elo3451/A24_ruler/Sponsor/README.md

# **Please Read**
Please contribute to this list so it does not get bad and unmaintained like the adawiki list this is based off.

# **The Basics**

- Don&#39;t ask for more than you need
- Do not resell samples (this is why TI stopped sending samples to students)
- Be prepared for a barrage of phone calls from some manufacturers.

- You may be questioned about the use of samples. Know your project

# **Side note**
Some companies use samplecomponents to process samples. This is a google query that'll find all of them
site:samplecomponents.com/scripts/samplecenter.dll?*?cmd=menu "sample center"
Please report back anything useful
# **The List**

# Recommended
[Maxim Integrated ](http://www.maximintegrated.com/)Sends samples only if you have a corporate/school email. Quick turnaround (3 days) and uses DHL Express WPX.

[Microchip ](https://www.microchip.com/samples/) IC's / Microcontrollers. They make all kinds of stuff. I used my personal email which is on a custom domain. They do not accept common emails such as @gmail.com. I have ordered from there so much and they do not bug you / &quot;follow up&quot;. DHL Express WPX.

[NXP](http://www.nxp.com/) IC's / Microcontrollers. Pretty good. They even offer free &quot;priority&quot; shipping if you click the button that asks. FedEX Express.

[Renesas](http://renesas.com/) IC's / Microcontrollers. Pretty good. They send samples of cheap stuff within a week and also fulfilled my requests for more expensive parts. FedEX Express.

[Micron](http://micron.com/) IC's / Microcontrollers. Sends samples free via USPS Priority Mail. Takes 1+ months.

[TE](http://te.com/) Passives, Connectors, Switches. TE Connectivity. Pretty good. Sent multiple orders with more expensive parts. All were shipped very quickly. I got 1 email from sales, but they haven&#39;t bugged me. FedEX Express.

[Amphenol ICC](http://amphenol-icc.com/) Connectors. Sent my connectors using UPS Saver. Pretty quick turnaround.

[Nexperia](http://www.nexperia.com/) ICs. Writing the sales office a short email about your project is the way to go. Very quick response and delivery.

# IC&#39;s / Microcontrollers

[Maxim Integrated ](http://www.maximintegrated.com/)Sends samples only if you have a corporate/school email. Quick turnaround (3 days) and uses DHL Express WPX.

[Analog Devices](http://www.analog.com/en/index.html) Samples only if you have a corporate/university E-Mail ID. Usually require an EORI number for EU shipping (you can fill in the field with N/A and mention you are a student) but this might get you in trouble with customs. You are required to fill in details about what project the samples will be used in. Only one samples account per person is allowed. Limit samples orders to two parts of each type, and five types in total.

[Texas Instruments (National Semi)](https://www-a.ti.com/apps/samp/basket.asp) TI says that samples requests are only for professional engineers and fobs you off to the TI Store.

[Microchip ](https://www.microchip.com/samples/)The Best. They make all kinds of stuff. I used my personal email. They do not accept common emails such as @gmail.com. I have ordered from there so much and they do not bug you / &quot;follow up&quot;

[Silicon Laboratories](http://www.silabs.com/) Sent request and was shipped quickly via DHL 

[STMicroelectronics](http://www.st.com/) Ordered and sent DHL non tracked. They want $7 for shipping to Australia. They had a free shipping offer for New Years.

[ON Semiconductor](http://www.onsemi.com/) ON wants $15 for shipping + $5 for handling. Have not tried.

[NXP](http://www.nxp.com/) Pretty good. They even offer free &quot;priority&quot; shipping if you click the button that asks.

[Cirrus Logic ](http://www.cirrus.com/)Haven&#39;t tried yet

[Allegro Microsystems](http://www.allegromicro.com/) No option for samples on website.

[Sensirion](http://www.sensirion.com/) No free samples at the moment.

[Central Semi](http://centralsemi.com/) Website is broken. Uses old recapcha.

[Zilog](http://www.zilog.com/) Not much choice. I requested samples a while ago and no response.

[Austria Microsystems](http://ams.com/) Gotten samples with no &quot;follow up&quot;. DHL Express WPX.

[Macronix International](http://macronix.com/) They do not want to send samples and if you really ask them, they will ask you for a shipping account number.

[Renesas](http://renesas.com/) Pretty good. They send samples of cheap stuff within a week and also fulfilled my requests for more expensive parts. FedEX Express.

[Micron](http://micron.com/) IC's / Microcontrollers. Sends samples free via USPS Priority Mail. Takes 1+ months.

[Micro Crystal](https://www.microcrystal.com/en/) Real Time clock and crystal oscilator. Sends a demo bard and 5 pieces sample. Forwarded my details to annoying distirbutor. FedEX Express.

[Nexperia](http://www.nexperia.com/) ICs. Writing the sales office a short email about your project is the way to go. Very quick response and delivery.

# Passives / Opto / Discrete Semi

[Vishay](http://vishay.com/) They don&#39;t send samples (if) you can find a part that Vishay &quot;stocks&quot;

[TE](http://te.com/) TE Connectivity. Pretty good. Sent multiple orders with more expensive parts. All were shipped very quickly. I got 1 email from sales, but they haven&#39;t bugged me. FedEX Express

[Würth Elektronik](https://www.we-online.com/catalog/en) Pretty good. Sales rep called me next day to check on project and to ask how I found out about them, etc. FedEX Express.

[Bivar](http://www.bivar.com/) They do not send samples and want you to buy them.

[Lite-On](http://us.liteon.com/en-global/Home/index) Sent request.

# Connectors

[TE](http://te.com/) Connectivity. Sent multiple orders with more expensive parts. I got 1 email from sales, but they haven&#39;t bugged me. FedEX Express.

[SamTec](http://www.samtec.com/) No response yet.

[Mill-Max](http://www.mill-max.com/) Sent request.

[Desco / Charleswater](http://desco.descoindustries.com/) Will only send to "professional engineers"

[ITW/Fastex](http://www.itw-fastex.com/catalog.html) Have not tried.

[Keystone electronics](http://www.keyelco.com/contact.asp) They sent my request to a distributor who has not contacted me.

[Metz Connect](https://www.metz-connect.com/us/sample-order) Have not tried.

[Memory Protection Devices](http://www.memoryprotectiondevices.com/morecorp.shtml) No form for samples on website. Have not tried emailing them.

[Norcomp](http://www.norcomp.net/Navpages/sample.htm) Need shipping account. Have not tried.

[Amphenol ICC](http://amphenol-icc.com/) Sent my connectors using UPS Saver. Pretty quick turnaround.

[3M](http://solutions.3m.com/wps/portal/3M/en_WW/electronics/home/SupportTraining/ContactUs/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) Their website is hard to navigate and I cannot find a samples request form for Australia.

# Enclosures

[PacTec Enclosures](http://www.pactecenclosures.com/free_sample.lfml) Have not tried.

[OKW Enclosures](http://www.okwenclosures.com/) - No responce.

[Serpac](http://www.serpac.com/) No responce. 

[Hammond Manufacturing](http://www.hammfg.com/) No sampling option on webpage. Have not tried.

# Switches

[NKK Switches](http://www.nkkswitches.com/) Shipping account required if you want UPS or FedEx. Have not tried.

[TE](http://te.com/) Connectivity. Sent multiple orders with more expensive parts. I got 1 email from sales, but they haven&#39;t bugged me.

# Others

[MicroMetals](http://www.micrometals.com/samples_index.html) No option on website. Have not tried.

[Fox Electronics](http://www.foxonline.com/) No responce.

[Purdy Electronics](http://www.purdyelectronics.com/) No form on website. They will send you off to a distributor to buy it.

[RichCo Inc](http://www.richco-inc.com/sampleframes.asp/) Have not tried.

[Coilcraft](http://www.coilcraft.com/) Inductors, Transformers and other high-quality magnetics. They are very generous with samples. You can contact a sales rep, and they will provide you with samples regardless of if you are working, a student or just an independent hobbyist. Contacting them through a regular E-Mail domain (e.g. @gmail.com) also works.

[Parallax](http://www.parallax.com/) No form on website. They said they do not do samples.

[LittelFuse](http://www.littelfuse.com/) Have not tried.

[Bourns](http://www.bourns.com/SampleReq.aspx) Not even going to try. Apparently they will pester you consistently.

[Ametherm](http://www.ametherm.com/SampleRequest.html) Free shipping only for usa and Canada. Have not tried.

[AVX Corporation](https://www.avx.com/RequestSample.asp) No responce.

[KOA Speer Electronics](http://www.koaspeer.com/order-samples/) Sales rep emailed me saying they do not send samples.

[Central Technologies](http://www.ctparts.com/) Have not tried.

[API Delevan](http://www.delevan.com/support/sample) Have not tried.

[SJS Products](http://www.sjsproducts.com/us/requests/request/quote) Have not tried.

[Ecliptek](http://www.ecliptek.com/) Asked for samples and no response.
