elo3451/A24_ruler/Remise finale/Documentation_conception/Notes de conception.pdf

Digikey - Atmega328P-AU (https://www.digikey.ca/en/products/detail/microchip-technology/ATMEGA328P-AU/1832260)
Symbole disponible sur Kicad
À voir le type d'empreinte disponible (modèle avec des pages vers l'extérieur)

Prix : 4.16$

Références:
Empreinte - SnapMagic (https://www.snapeda.com/parts/ATMEGA328P-AU/Microchip/view-part/)
Informations - Mouser (https://www.mouser.ca/ProductDetail/Microchip-Technology/ATMEGA328P-AU?qs=K8BHR703ZXiCmmgp6%2FGNmQ%3D%3D)
IGM - Arduino : getting started (https://igm.univ-mlv.fr/~dr/XPOSE2013/arduino/started.html) Pins type - DANKC (https://dankc.com/using-atmega328p-8-16-20mhz/)
Fiches technique - ATMEGA328P-AU (https://www.alldatasheet.fr/datasheet-pdf/download/392285/ATMEL/ATMEGA328P-AU.html)
Hardware design considerations | AN2519-AV R-Microc...
Manuel | ATMEGA32 8p (1) (1)
Measure VCC/Battery Voltage Without Using I/O Pin on tinyAVR and megaAVR | 00002447A

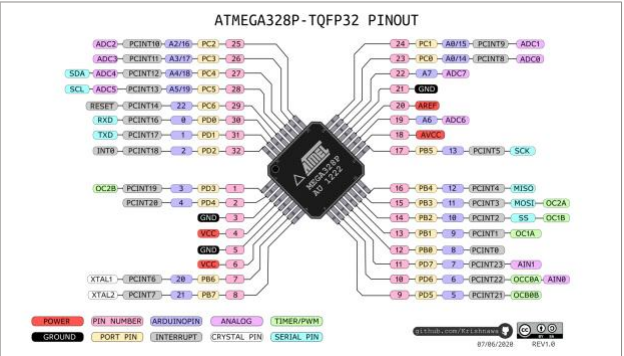
[picture p1: figure]
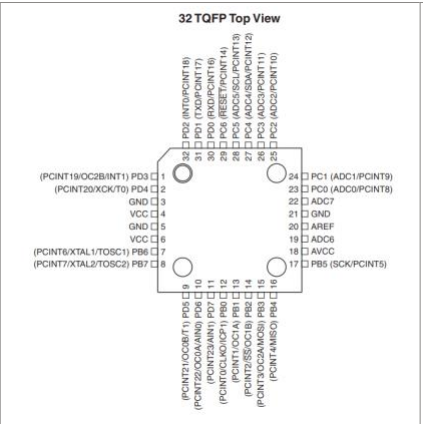
[picture p2: figure]

Pin layout (p.12):

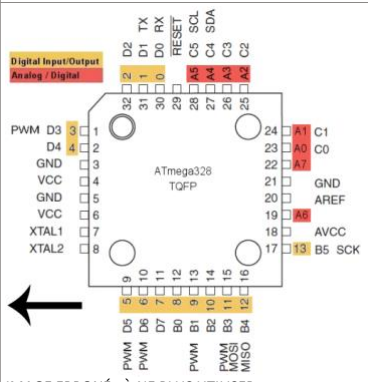
[picture p3: figure]

IMAGE ERRONÉ - À NE PLUS UTILISER

## Atmega328P-AU (TQFP)

mercredi 30 octobre 2024 20:05

A24 - Inch2Cent Page 1

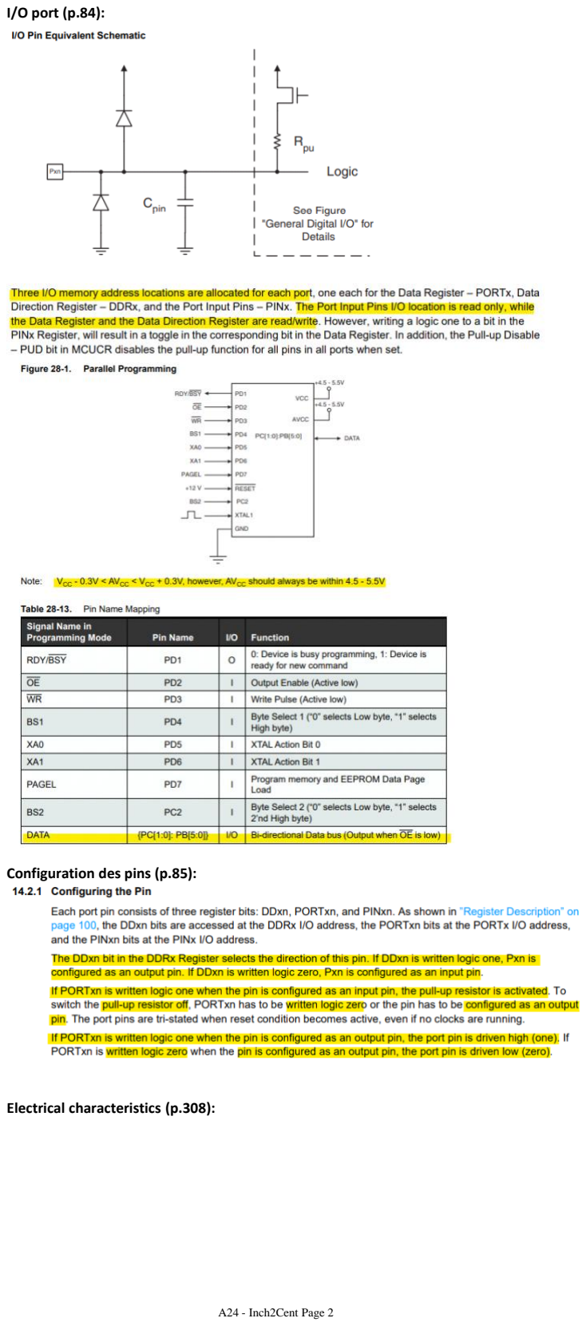
[picture p4: page 2]

I/O port (p.84):

Configuration des pins (p.85):

Electrical characteristics (p.308):

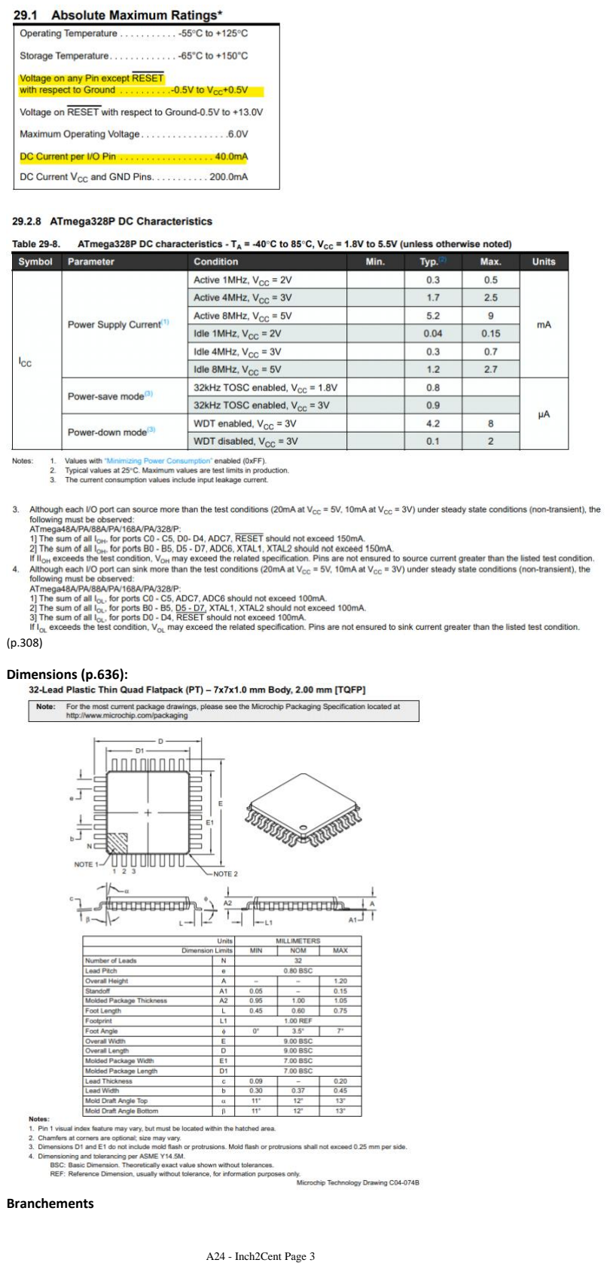
[picture p5: page 3]

(p.308)

Dimensions (p.636):

Branchements

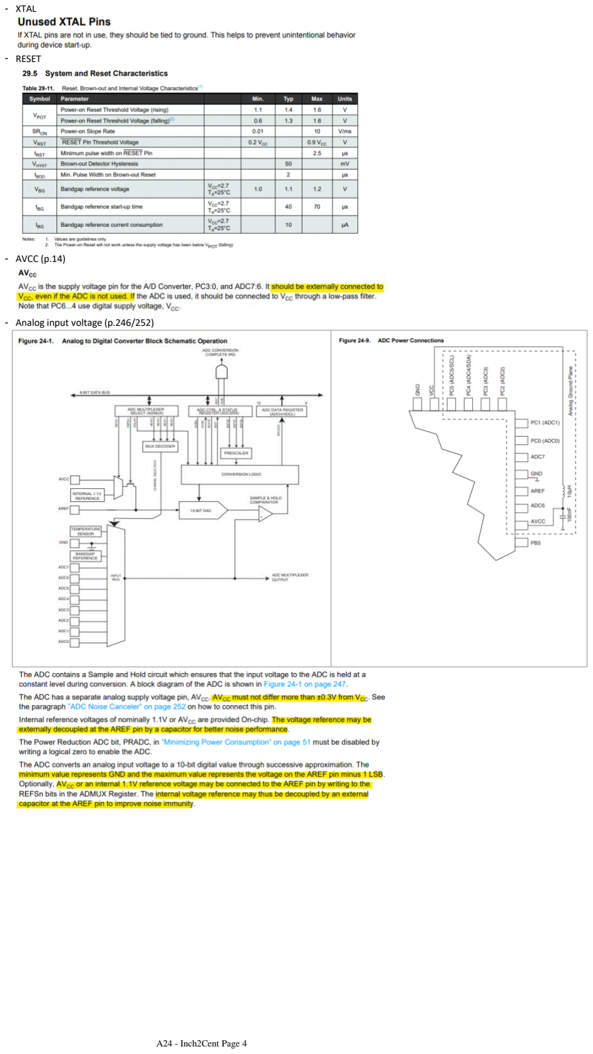
[picture p6: page 4]

- XTAL
- RESET
- AVCC (p.14)
- Analog input voltage (p.246/252)

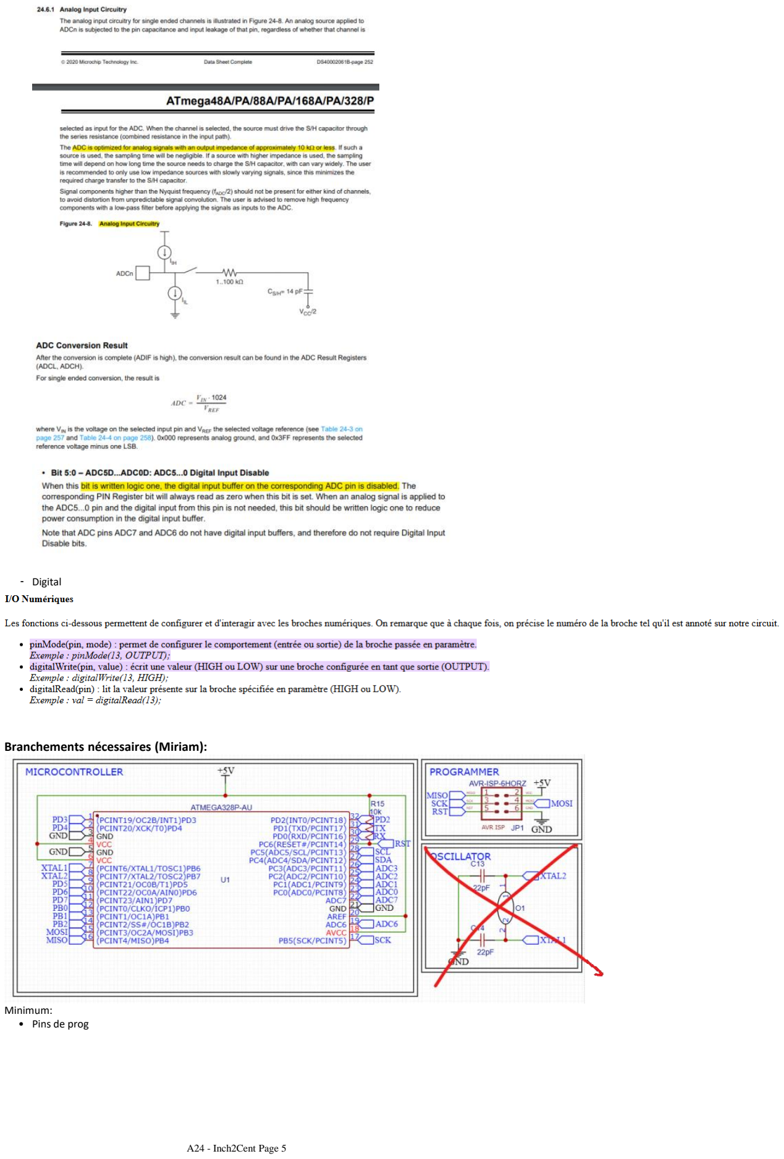
[picture p7: page 5]

- Digital

Branchements nécessaires (Miriam):

Minimum:
- Pins de prog

Les branchements du programmer prennent des pins comme ceux-là et le schéma ici. Branchements (p.9)

○

- MOSI, MISO, SCK, RST
Recommande un bouton avec un filtre passe-bas pour RST (reset le board au besoin) Branchements (p.7-8)Recommande:

○

Pins de debug
- TX et RX (UART)
- Fonctionne un peu comme serial.print de l'arduino

•

Emplacement du code : C:\Users\elo34\Documents\PlatformIO\Projects\Inch2Cent\src

1. Programmation ATMEGA328P
2. Concept

# Programmation

lundi 25 novembre 2024 19:10

Informations fournies par Miriam:
Utilisation de Microchip ou VS Code pour programmer ou Arduino IDE.
Manipulations afin de setup la plateforme :
Arduino IDE : https://docs.arduino.cc/built-in-examples/arduino-isp/ArduinoISP/
Il faut intégrer les librairies Arduino dans les bons fichiers pour les deux logiciels (comme on fait sur VS Code).
Programmation de base en C/C++ comme Arduino
Fuse programming = donner certaines informations à ton atmega

VS Code
Plateformio - Atmel AVR (https://docs.platformio.org/en/latest/platforms/atmelavr.html#configuration)
Programming AVR Chips Using Visual Studio Code (https://www.instructables.com/Programming-AVR-Chips-Using-Visual-Studio-Code/)
Localisation du projet : C:\Users\elo34\Documents\PlatformIO\Projects\Inch2Cent Type de configuration : AVRISP mkII

Microchip (NOT FONCTIONNAL) Microchip Studio for AVR (https://www.microchip.com/en-us/tools-resources/develop/microchip-studio)
2 Getting Started (https://onlinedocs.microchip.com/oxy/GUID-ECD8A826-B1DA-44FC-BE0B-5A53418A47BD-en-US-12/GUID-00257F02-E33C-40C3-B324-83DBCC05EC30.html)
Creating a new project (https://onlinedocs.microchip.com/oxy/GUID-ECD8A826-B1DA-44FC-BE0B-5A53418A47BD-en-US-12/GUID-0661DC83-89AB-44A0-8AD5-CACC9174EAE7.html)
Project Type used : GCC C++ Executable Project (C/C++) Maker and DIY Solutions (https://www.microchip.com/en-us/tools-resources/evaluation-boards/maker-diy-solutions)
Creating Arduino Sketches in Atmel Studio (p.13)

Atmel-4243
9-From-M...

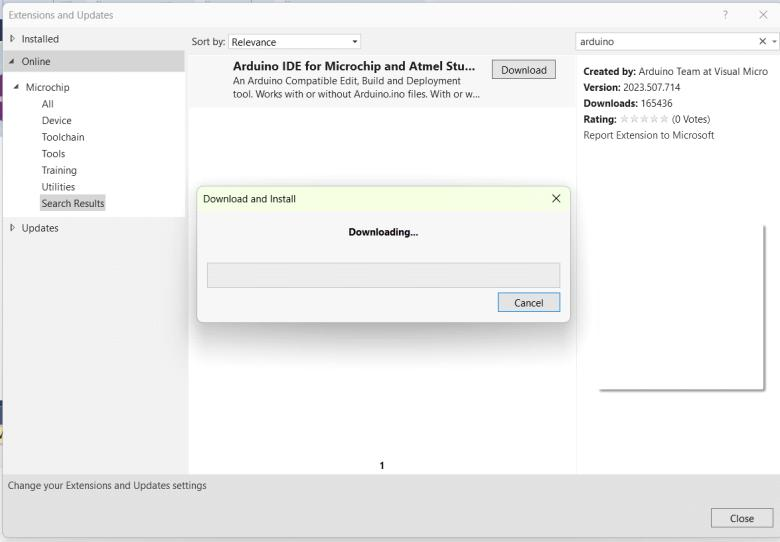
[picture p8: figure]

Impossible de download. Certaines personnes ont le problème (https://forum.microchip.com/s/topic/a5CV40000001TZRMA2/t396532) depuis juin.

# 1. Programmation ATMEGA328P

jeudi 5 décembre 2024 22:07

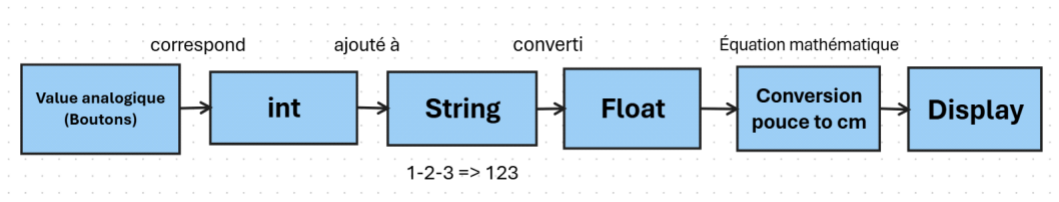
[picture p9: figure]

1. Lecture des boutons
2. Jumeler les chiffres en nombre
3. Conversion
4. Display 7 segments
5. Vider la liste de chiffres
6. DEL d'incertitude
7. NOT USED - Modifier le range des boutons en fonction de VCC

Lecture des boutons

Multiple pushbuttons on one Arduino Input (https://www.the-diy-life.com/multiple-push-buttons-on-one-arduino-input/)
1. Identifier la pin avec ce qu'elle représente.
2. Initialiser buttonValue = 0;
3. buttonValue = analogRead(pin);
4. Boucle de if afin de vérifier le bouton sélectionné

Déterminer le range pour les if
1. Calculer la tension attendue avec la résistance mise Calculer le nombre entre 0 et 1023 qui est équivalent
- Vth / Vmax * 1023

2.

3. Ajouter entre 5 et 20 de chaque côté de la valeur pour faire le range ** Plus il y a de boutons, plus le range est petit

Voir Conception.xls pour les ranges sélectionnés
NOT USED
Les ranges changent constamment à cause de la tension d'entrée qui varie (batterie se vide) Remplacer par un code qui calcule les ranges selon VCC : Modifier le range des boutons en fonction de VCC

### Jumeler les chiffres en nombre

Utilisation de String

ARDUINO DOCS - String() (https://docs.arduino.cc/language-reference/en/variables/data-types/stringObject/)
- String Number = String(char); Append : += (ajout à la fin du String)
- myString1 += data;

•

ARDUINO DOCS - toFloat() (https://docs.arduino.cc/language-reference/en/variables/data-types/stringObject/Functions/toFloat/)
- Convertir String to a float
- String doit commencer par un digit. Sinon, retourne zéro.
La fonction arrondit à deux chiffres après la virgule et ignore tous les caractères qui ne sont pas des chiffres ou le point.

•

# 2. Concept

jeudi 5 décembre 2024 22:07

•myString.toFloat();

https://forum.arduino.cc/t/how-do-you-convert-a-float-to-string-solved/237090https://forum.arduino.cc/t/solved-keypad-number-input-and-store/57566https://www.best-mi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,a%20parameter%20and%20returns%20the%20corresponding%20float%20value. (https://www.best-microcontroller-projects.com/arduino-string-to-float.html)

Conversion
L'ensemble des valeurs entrées sur le clavier sont en pouce dans le but de les convertir en centimètre.
1 po = 2.54 cm
Limitation : Conversion possible

Les cas d'affichage pour les conversions en fonction des limitations
Si lengthToConvert > 390 | Retourne 1000 | Afficher sur le display ---Allumer DEL
Si lengthToConvert < 390 && lengthToConvert > 39 | Retourne la valeur arrondie (aucune décimale) ex : 112.3 => 112 | Afficher sur le display le nombre arrondi sans décimale Allumer DEL
Si lengthToConvert < 39 | Retourne la valeur arrondie jusqu'à 2 décimale selon la valeur | Afficher sur le display le nombre arrondi avec décimale

Display 7 segments

Afficheur_LEDS_7seg (https://www.sonelec-musique.com/electronique_realisations_afficheur_leds_7seg_006.html)

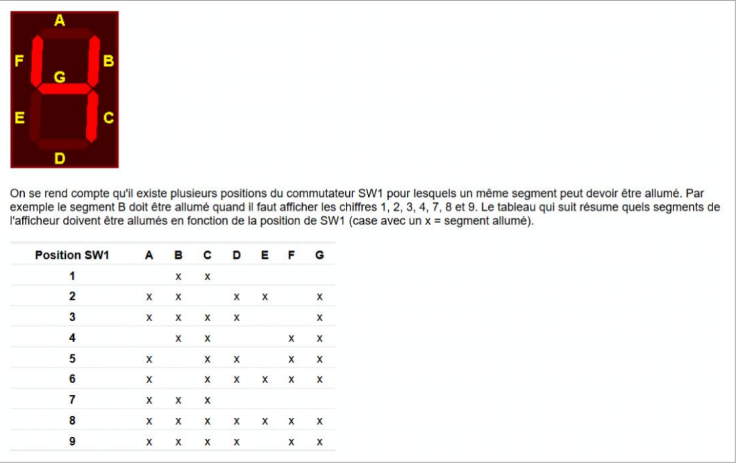
[picture p10: figure]

Comment utiliser un AFFICHEUR 7 segments (https://youtu.be/Xk1HupMvxNs?si=2SHEMkatT34iE-cK)
- Les branchements DIG permettent d'activer et désactiver chaque digits.
- Les branchements en lettre permettent de contrôler le même segment dans tous les digits.

Multiplexage : Afficher un digit à la fois avec une rotation rapide pour donner l'impression que tous les chiffres s'affichent en même temps.

•

1. Identifier chaque pin avec ce qu'elle représente.
Setup()
Initialiser les pins qui sont présentées en 1. dans setup()
- pinMode(pin, OUTPUT);

1.

Désactiver tous les digits pour éviter qu'ils s'allument
- Faire en sorte que la différence de potentiel est 0.
- digitalWrite(digit, HIGH);

2.

2.

Loop()
1.Définir les fonctions utiles à l'affichage

3.

Possible de prendre un nombre à plusieurs digits et de le séparer en chiffre. -Diviser le nombre en plusieurs variables.
Le code utilisé dans la vidéo.

imake-code
-afficheur...

Gérer les décimales dans l'affichage (elle n'est pas toujours au même emplacement)

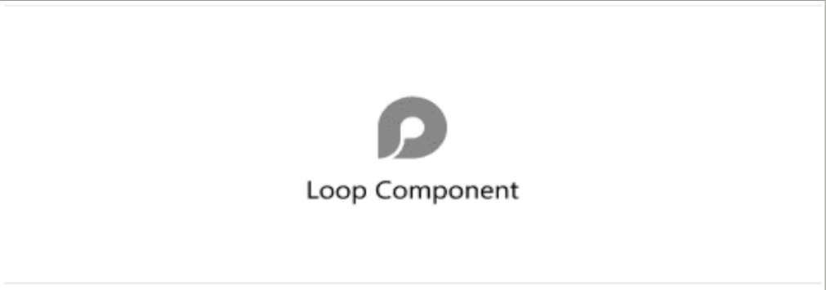
[picture p11: figure]

Gestion de l'affichage
Le display est allumé pendant 15 secondes à l'aide d'une fonction while(). On prend le temps avant avec millis, puis on vérifie dans le while si le temps présent est 15 secondes plus tard ou non.

•

- L'activation de la DEL d'incertitude se fait dans l'activation des différents digits de l'affichage.

Vider la liste de chiffres

Effectuer le RESET

NOT USED
Clear the string or the char before using it again : How to clear of contents of string in Arduino? (https://arduino.stackexchange.com/questions/19442/how-to-clear-of-contents-of-string-in-arduino) All you would need to do to "clear" this string is to assign a null to the first character. For example: foo[0] = '\0';

str.remove(0);
Doit réinitialiser la longueur.

Pour vérifier si String est empty => str.empty(); Si retourne TRUE => str est empty

Comment procéder pour déclencher le RESET?

Présentement | • Le RESET s'effectue automatiquement après le 15 secondes d'affichage. On ne peut pas déclencher le RESET volontairement, on doit attendre.
À vérifier | • Voir s'il est possible d'implanter un bouton de RESET. • Possiblement lorsque le '.' est sélectionné après 'e'. À voir si le while n'empêche pas la lecture de nouveaux boutons en même temps. •Nécessite peut-être un retravail des fonctions pour le permettre

DEL d'incertitude
En fonction des limitations : Conversion possible
Les cas d'affichage sont présents ici.

La DEL est activé si aucune décimale du nombre à afficher est présente. Aussi, si l'écran tombe en erreur (---), elle s'allume. Ces cas sont présents lorsque decimalPosition est égal à 0 ou 3.

Pour ce faire, digitalWrite() est utilisé. La commande d'affichage est intégrée dans l'affichage du display. Ainsi, à chaque fois qu'un digit allume (au 2 millisecondes), la DEL allume aussi.

NOT USED - Modifier le range des boutons en fonction de VCC
Fonctions nécessaires :
- Déterminer VCC
Déterminer la tension IO pour chaque résistance

○

•

Déterminer la valeur analogique pour cette tension IO

○

•

NOT USED
Pour déterminer VCC à ce moment-ci : Measure VCC/Battery Voltage Without Using I/O Pin on Basé sur ce code:

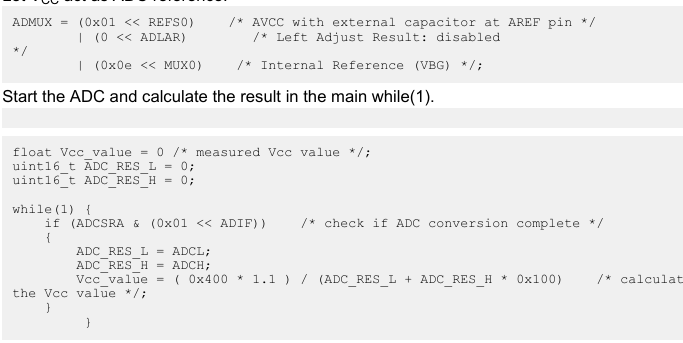
[picture p12: figure]

Étant donné que ce sont toujours les mêmes references et inputs channel, ADMUX peut être mis dans setup()

•

La deuxième section du code peut être mise dans une fonction. Si l'on veut déterminer VCC à un moment précis, il faut retirer la loop while. Sinon, le code va rester pris dans une boucle

•

sans fin.

Utilisez plusieurs fichiers - Apprenez à programmer en C++ - OpenClassrooms (https://openclassrooms.com/fr/courses/1894236-apprenez-a-programmer-en-c/7565936-utilisez-plusieurs-fichiers)

# Créer de nouveaux fichiers pour les fonctions

mardi 3 décembre 2024 19:34

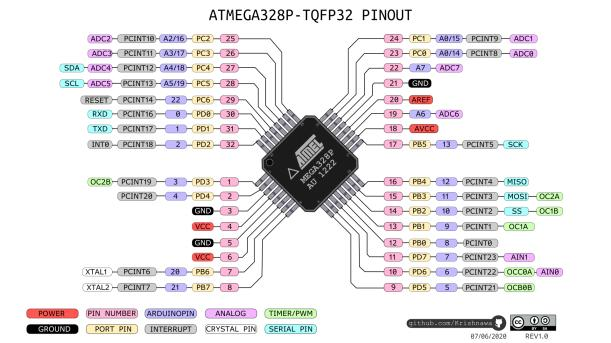
[picture p13: figure]

Le numéro de pin de la chip ne correspond pas au numéro de pin à mettre dans le code.

Physiquement, une pin peut être nommée 9, mais dans Arduino c'est plutôt DI5 (la bulle mauve dans l'image).

Pour nommer les pins dans le code, il faut se fier à cette image.

# Programmer un chip avec Arduino.h

samedi 21 décembre 2024 16:22

Limitations
Conversion possible
- Si l'on veut un nombre précis (avec une décimale) => rester sous 39 po (100 cm) Si l'on veut un nombre sous 4 digits avec arrondissement (possible à mettre sur le display) => gros max 390 po (990.6 cm)

○

# Spécifications projet

lundi 25 novembre 2024 20:01
