elo3451/A24_ruler/Remise finale/BOM_5_.pdf

BOM Inch2Cent

Référence | Quantité | Valeur | Footprint | Distributeur | Numéro du distributeur | Prix unitaire | Coût total
BT1 | 1 | Battery | XDCR-1220-006_THT:XDCR-1220-006 | LCSC | C964744 | 0,104 | 0,104
C1,C2 | 2 | 100n | C1206C104K5RAC7210:CAPC3216X88N | Digikey | 399-C1206C104K5RAC7210CT-ND | 0,081 | 0,162
C3 | 1 | 470n | C1206C104K5RAC7210:CAPC3216X88N | Digikey | 445-12986-1-ND | 0,144 | 0,144
C4 | 1 | 68n | C1206F683K2RACTU:CAPC340180_185N_KEM | Digikey | 399-11949-1-ND | 0,166 | 0,166
D1 | 1 | LED | 150120SS75000:WL-SMCW_1206 | Digikey | 732-4992-1-ND | 0,340 | 0,340
DIS1 | 1 | LTC-4724JF | LTC-4724JF:LTC4724JF | Digikey | 160-1543-5-ND | 5,060 | 5,060
F1 | 1 | 0.37 | SMD1206B005TF:FUSE_SMD1206_YAG | Digikey | 13-SMD1206B016TFCT-ND | 0,135 | 0,135
J1 | 1 | AVR-ISP-6 | PH2-06-UA:CONN_PH2-06-UA_ADM | Digikey | 2057-PH2-06-UA-ND | 0,150 | 0,150
R0 | 1 | 11k | digikey-footprints:1206 | Digikey | 311-11.0KFRTR-ND | 0,038 | 0,038
R1 | 1 | 4.99k | digikey-footprints:1206 | Digikey | 311-4.99KFRTR-ND | 0,041 | 0,041
R2 | 1 | 3k | digikey-footprints:1206 | Digikey | 311-3.0KERTR-ND | 0,033 | 0,033
R3 | 1 | 2k | digikey-footprints:1206 | Digikey | 311-2.00KFRTR-ND | 0,041 | 0,041
R4,R20 | 2 | 1.4k | digikey-footprints:1206 | Digikey | 311-1.40KFRTR-ND | 0,028 | 0,056
R5,R10 | 2 | 1k | digikey-footprints:1206 | Digikey | 311-1.00KFRTR-ND | 0,041 | 0,082
R6 | 1 | 750 | digikey-footprints:1206 | Digikey | 311-750FRTR-ND | 0,041 | 0,041
R7 | 1 | 510 | digikey-footprints:1206 | Digikey | 311-510FRTR-ND | 0,041 | 0,041
R8 | 1 | 330 | digikey-footprints:1206 | Digikey | 311-330FRTR-ND | 0,038 | 0,038
R9 | 1 | 205 | digikey-footprints:1206 | Digikey | 311-205FRTR-ND | 0,034 | 0,034
R11,R12,R13, R14,R15,R16, R17,R18 | 8 | 39 | digikey-footprints:1206 | Digikey | 13-AC1206FR-0739RLTR-ND | 0,033 | 0,264
R19 | 1 | 4.7k | digikey-footprints:1206 | Digikey | 311-4.70KFRTR-ND | 0,028 | 0,028
R21 | 1 | 33 | digikey-footprints:1206 | Digikey | 311-33.0FRTR-ND | 0,041 | 0,041
R_E1 | 1 | 6.8 | digikey-footprints:1206 | Digikey | RMCF1206FT6R80TR-ND | 0,049 | 0,049
R_P1 | 1 | 91 | digikey-footprints:1206 | Digikey | 311-91.0FRTR-ND | 0,041 | 0,041
SW0,SW1,SW2,S W3,SW4,SW5,S W6,SW7,SW8,S W9,SW_E1, SW_P1, SW_RST1 | 13 | SW_SPST | Button_Switch_SMD:SW_Tactile_SPST_NO_Straight_CK_PTS636Sx25SMTRLFS | Digikey | CKN12329-1-ND | 0,344 | 4,472
SW10 | 1 | SLW-66527511-SMT-TR | SLW-66527511-SMT-TR:SLW-66527511-SMT-TR_CUD | Digikey | 2223-SLW-66527511-SMT-TRCT-ND | 0,890 | 0,890
U1 | 1 | ATMEGA328P-AU | digikey-footprints:TQFP-32_7x7mm | Digikey | ATMEGA328P-AU-ND | 4,160 | 4,160
PCB | 1 | PCB | --- | --- | --- | 4,000 | 4,000
TOTAL | 20,651

26/12/2024
