elo3451/A24_ruler/Remise finale/Documentation_conception/Conception.xlsx

Sheet: Assignation pins
Types de pin | # | Noms | Branchements | Utilités | # Arduino | Type de pin
DIGITAL I/O | 1 | PD3 |  |  | 3 | ANALOG/DIGITAL
DIGITAL I/O | 2 | PD4 | E_7SEG | Écran | 4 | DIGITAL I/O
ALIM | 3 | GND | GND | Ground |  | UART
ALIM | 4 | VCC | 5V+ | Alimentation DC |  | ALIM
ALIM | 5 | GND | GND | Ground
ALIM | 6 | VCC | 5V+ | Alimentation DC
 | 7 | PB6 | GND | XTAL1 | 20
 | 8 | PB7 | GND | XTAL2 | 21
DIGITAL I/O | 9 | PD5 | DIG1_7SEG | Écran | 5
DIGITAL I/O | 10 | PD6 | C_7SEG | Écran | 6
DIGITAL I/O | 11 | PD7 | DIG2_7SEG | Écran | 7
DIGITAL I/O | 12 | PB0 | D_7SEG | Écran | 8
DIGITAL I/O | 13 | PB1 | DIG3_7SEG | Écran | 9
DIGITAL I/O | 14 | PB2 | DP_7SEG | Écran | 10
DIGITAL I/O | 15 | PB3 | MOSI | Programmer | 11
DIGITAL I/O | 16 | PB4 | MISO | Programmer | 12
DIGITAL I/O | 17 | PB5 | SCK | Programmer | 13
ALIM | 18 | AVCC | 5V+ | Alimentation AC
ANALOG/DIGITAL | 19 | ADC6 |  |  | A6
ALIM | 20 | AREF | 5V+ | Référence ACC
ALIM | 21 | GND | GND | Ground
ANALOG/DIGITAL | 22 | ADC7 |  |  | A7
ANALOG/DIGITAL | 23 | PC0 | B_7SEG | Écran | A0/14
ANALOG/DIGITAL | 24 | PC1 | G_7SEG | Écran | A0/15
ANALOG/DIGITAL | 25 | PC2 | D_INCERTITUDE | DEL incertitude | A2/16
ANALOG/DIGITAL | 26 | PC3 | F_7SEG | Écran | A3/17
ANALOG/DIGITAL | 27 | PC4 | A_7SEG | Écran | A4/18
ANALOG/DIGITAL | 28 | PC5 | KEYBOARD | Keyboard | A5/19
 | 29 | PC6 | RST_MC | Programmer | 22
UART | 30 | PD0 | RX | Débugger Micro-contrôlleur | 0
UART | 31 | PD1 | TX | Débugger Micro-contrôlleur | 1
DIGITAL I/O | 32 | PD2 |  |  | 2

Sheet: Assignation pins (original)
Types de pin | # | Noms | Branchements | Utilités | Type de pin
DIGITAL I/O | 1 | PD3 | E_7SEG | Écran | ANALOG/DIGITAL
DIGITAL I/O | 2 | PD4 | C_7SEG | Écran | DIGITAL I/O
ALIM | 3 | GND | GND | Ground | UART
ALIM | 4 | VCC | 5V+ | Alimentation DC | ALIM
ALIM | 5 | GND | GND | Ground
ALIM | 6 | VCC | 5V+ | Alimentation DC
 | 7 | PB6 | GND | XTAL1
 | 8 | PB7 | GND | XTAL2
DIGITAL I/O | 9 | PD5 | D_7SEG | Écran
DIGITAL I/O | 10 | PD6 | DIG2_7SEG | Écran
DIGITAL I/O | 11 | PD7 | DP_7SEG | Écran
DIGITAL I/O | 12 | PB0 | DIG3_7SEG | Écran
DIGITAL I/O | 13 | PB1 | G_7SEG | Écran
DIGITAL I/O | 14 | PB2 | B_7SEG | Écran
DIGITAL I/O | 15 | PB3 | MOSI | Programmer
DIGITAL I/O | 16 | PB4 | MISO | Programmer
DIGITAL I/O | 17 | PB5 | SCK | Programmer
ALIM | 18 | AVCC | 5V+ | Alimentation AC
ANALOG/DIGITAL | 19 | ADC6
ALIM | 20 | AREF | 5V+ | Référence ACC
ALIM | 21 | GND | GND | Ground
ANALOG/DIGITAL | 22 | ADC7
ANALOG/DIGITAL | 23 | PC0 | A_7SEG | Écran
ANALOG/DIGITAL | 24 | PC1 | F_7SEG | Écran
ANALOG/DIGITAL | 25 | PC2 | KEYBOARD | Keyboard
ANALOG/DIGITAL | 26 | PC3 | D_INCERTITUDE | DEL incertitude
ANALOG/DIGITAL | 27 | PC4
ANALOG/DIGITAL | 28 | PC5
 | 29 | PC6 | RST_MC | Programmer
UART | 30 | PD0 | RX | Débugger Micro-contrôlleur
UART | 31 | PD1 | TX | Débugger Micro-contrôlleur
DIGITAL I/O | 32 | PD2 | DIG1_7SEG | Écran

Sheet: Budget
 | Item | Format | Lien | Coût | Qté | Coût unitaire | Site | Qté nécessaire | Coût pour un PCB |  |  |  |  | Sites | Format
 | R 11k (1%) | 1206 | https://www.digikey.ca/en/products/detail/yageo/RC1206FR-0711KL/728500 | 0.38 | 10 | 0.038 | Digikey | 1 | 0.038 |  | BUDGET | 100 | $ | Digikey | 2010
 | R 4.99k (1%) | 1206 | https://www.digikey.ca/en/products/detail/yageo/RC1206FR-074K99L/728896 | 0.41 | 10 | 0.041 | Digikey | 1 | 0.041 |  | BUDGET D'UN PCB | 25 | $ | LCSC | 1206
 | R 3k (5%) | 1206 | https://www.digikey.ca/en/products/detail/yageo/RC1206JR-073KL/729264 | 0.33 | 10 | 0.033 | Digikey | 1 | 0.033 |  |  |  |  |  | 805
 | R 2k (1%) | 1206 | https://www.digikey.ca/en/products/detail/yageo/RC1206FR-072KL/728612 | 0.41 | 10 | 0.041 | Digikey | 1 | 0.041 |  | *** Voir si on en prend plus |  |  |  | 603
 | R 1.4k (1%) | 1206 | https://www.digikey.ca/en/products/detail/yageo/RC1206FR-071K4L/728432 | 0.28 | 10 | 0.028 | Digikey | 2 | 0.056 |  |  |  |  |  | --
 | R 1k (1%) | 1206 | https://www.digikey.ca/en/products/detail/yageo/RC1206FR-071KL/728387 | 0.41 | 10 | 0.041 | Digikey | 2 | 0.082 |  | Coût de fabrication d'un PCB | 4 | $
 | R 750 (1%) | 1206 | https://www.digikey.ca/en/products/detail/yageo/RC1206FR-07750RL/729097 | 0.41 | 10 | 0.041 | Digikey | 1 | 0.041
 | R 510 (1%) | 1206 | https://www.digikey.ca/en/products/detail/yageo/RC1206FR-07510RL/728977 | 0.41 | 10 | 0.041 | Digikey | 1 | 0.041
 | R 330 (1%) | 1206 | https://www.digikey.ca/en/products/detail/yageo/RC1206FR-07330RL/728822 | 0.38 | 10 | 0.038 | Digikey | 1 | 0.038
 | R 205 (1%) | 1206 | https://www.digikey.ca/en/products/detail/yageo/RC1206FR-07205RL/728677 | 0.34 | 10 | 0.034 | Digikey | 1 | 0.034
 | R 91 (1%) | 1206 | https://www.digikey.ca/en/products/detail/yageo/RC1206FR-0791RL/729168 | 0.41 | 10 | 0.041 | Digikey | 1 | 0.041
 | R 6.8 (1%) | 1206 | https://www.digikey.ca/en/products/detail/stackpole-electronics-inc/RMCF1206FT6R80/2417450 | 0.49 | 10 | 0.049 | Digikey | 1 | 0.049
 | R 39 (1%) | 1206 | https://www.digikey.ca/en/products/detail/yageo/AC1206FR-0739RL/5897499 | 0.50 | 15 | 0.033 | Digikey | 8 | 0.267
 | R 33 (1%) | 1206 | https://www.digikey.ca/en/products/detail/yageo/RC1206FR-0733RL/728818 | 0.41 | 10 | 0.041 | Digikey | 1 | 0.041
 | R 4.7k (1%) | 1206 | https://www.digikey.ca/en/products/detail/yageo/RC1206FR-074K7L/728887 | 0.28 | 10 | 0.028 | Digikey | 1 | 0.028
 | button | -- | https://www.digikey.ca/fr/products/detail/c-k/PTS636-SM25F-SMTR-LFS/10071742 | 8.60 | 25 | 0.344 | Digikey | 13 | 4.472
 | connector (2x3) | -- | https://www.digikey.ca/en/products/detail/adam-tech/PH2-06-UA/9830396 | 0.30 | 2 | 0.150 | Digikey | 1 | 0.15
 | DEL |  | https://www.digikey.ca/en/products/detail/w%C3%BCrth-elektronik/150120SS75000/4489942 | 1.02 | 3 | 0.340 | Digikey | 1 | 0.34
 | switch | -- | https://www.digikey.ca/en/products/detail/same-sky-formerly-cui-devices/SLW-66527511-SMT-TR/21259964 | 2.67 | 3 | 0.890 | Digikey | 1 | 0.89
 | battery holder | -- | https://www.lcsc.com/product-detail/Button-And-Strip-Battery-Connector_MYOUNG-BS-02-A1BK007_C964744.html | 0.52 | 5 | 0.104 | LCSC | 1 | 0.104 | Prendre ceux à Miriam
3.0 V /220 mAh | battery | -- | -- | 1.45 | 2 | 0.725 |  | 1 | 0.725
 | fuse | 1206 | https://www.digikey.ca/en/products/detail/yageo/SMD1206B016TF/13689533 | 1.35 | 10 | 0.135 | Digikey | 1 | 0.135
 | C 100n | 1206 | https://www.digikey.ca/en/products/detail/kemet/C1206C104K5RAC7210/3317012 | 0.81 | 10 | 0.081 | Digikey | 2 | 0.162
 | C 68n | 1206 | https://www.digikey.ca/en/products/detail/kemet/C1206F683K2RACTU/5267612 | 1.66 | 10 | 0.166 | Digikey | 1 | 0.166
 | C 470n | 1206 | https://www.digikey.ca/en/products/detail/tdk-corporation/CGA5F2X8R1E474M085AA/3950222 | 1.44 | 10 | 0.144 | Digikey | 1 | 0.144
 | atmega | -- | https://www.digikey.ca/en/products/detail/microchip-technology/ATMEGA328P-AU/1832260 | 12.48 | 3 | 4.160 | Digikey | 1 | 4.160
 | display | -- | https://www.digikey.ca/en/products/detail/liteon/LTC-4724JF/408216 | 10.12 | 2 | 5.060 | Digikey | 1 | 5.06 | ***
 |  |  | TOTAL | 52.27 | $ |  |  | TOTAL | 20.654 | $
 |  |  | SOLDE RESTANT | 47.73 | $ |  |  | SOLDE RESTANT | 4.346333333 | $

Sheet: Clavier
Déterminer les résistances pour le clavier |  |  |  |  |  |  |  |  |  | Déterminer les ranges pour la programmation (avec les R sélectionnées) |  |  |  |  |  | Vérification (pas égal à un autre ou overlap)
Buttons | Tension au IO | Analog value | V (R1) | R1 (th) | R1 (pr) | Current |  |  |  | Buttons | R1 (pr) | Tension au IO | Analog value | Bottom range | High range
0 | 0.25 | 85.25 | 2.75 | 11000 | 11000 | 0.0003 | VCC | 3 | V | 0 | 11000 | 0.250 | 85.25 | 55.25 | 115.25 | TRUE
1 | 0.50 | 170.5 | 2.50 | 5000 | 4990 | 0.0005 | Analog input | 1023 |  | 1 | 4990 | 0.501 | 170.7846411 | 140.7846411 | 200.7846411 | TRUE
2 | 0.75 | 255.75 | 2.25 | 3000 | 3000 | 0.0008 | R10 | 1000 | ohms | 2 | 3000 | 0.750 | 255.75 | 225.75 | 285.75 | TRUE
3 | 1.00 | 341 | 2.00 | 2000 | 2000 | 0.0010 |  |  |  | 3 | 2000 | 1.000 | 341 | 311 | 371 | TRUE
4 | 1.25 | 426.25 | 1.75 | 1400 | 1400 | 0.0013 | Range | 30 |  | 4 | 1400 | 1.250 | 426.25 | 396.25 | 456.25 | TRUE
5 | 1.50 | 511.5 | 1.50 | 1000 | 1000 | 0.0015 |  |  |  | 5 | 1000 | 1.500 | 511.5 | 481.5 | 541.5 | TRUE
6 | 1.75 | 596.75 | 1.25 | 714.2857143 | 750 | 0.0017 |  |  |  | 6 | 750 | 1.714 | 584.5714286 | 554.5714286 | 614.5714286 | TRUE
7 | 2.00 | 682 | 1.00 | 500 | 510 | 0.0020 |  |  |  | 7 | 510 | 1.987 | 677.4834437 | 647.4834437 | 707.4834437 | TRUE
8 | 2.25 | 767.25 | 0.75 | 333.3333333 | 330 | 0.0023 |  |  |  | 8 | 330 | 2.256 | 769.1729323 | 739.1729323 | 799.1729323 | TRUE
9 | 2.50 | 852.5 | 0.50 | 200 | 205 | 0.0024 |  |  |  | 9 | 205 | 2.490 | 848.9626556 | 818.9626556 | 878.9626556 | TRUE
Point | 2.75 | 937.75 | 0.25 | 90.90909091 | 91 | 0.0027 |  |  |  | Point | 91 | 2.750 | 937.6718607 | 907.6718607 | 967.6718607 | TRUE
Enter | 2.98 | 1016.18 | 0.02 | 6.711409396 | 6.8 | 0.0029 |  |  |  | Enter | 6.8 | 2.980 | 1016.090584 | 986.090584 | 1023 | TRUE
Résolution | 10 | bits
Précision ADC | 0.003 | V
Condensateur
Valeur max | 11000 | ohms
Valeur min | 6.8 | ohms
Fréquence de coupure | 1336.898396 | Hz | *choisi
Temps | 0.0007 | s |  |  | 6.8e-08
 |  |  |  |  | 1336.898396 | 0.000748
fc = 1/(RC)
C (11k) | 6.8e-08
C (6.8) | 0.00011 |  | fc de 6.8 si C = 68n | 2162629.758 | Hz
 |  |  |  | 4.624e-07 | s
NOT USED
Filtre anti-rebond |  | https://www.digikey.ca/fr/resources/conversion-calculators/conversion-calculator-low-pass-and-high-pass-filter
R | 1000 | ohms
C | 0.22 | uF
f | 723.43 | Hz

Sheet: Display 7 segments
Continuous forward current per segment | If | 0.025 | A
Forward voltage per segment (typ) | Vf | 2.05 | V
Forward voltage per segment (max) | Vf | 2.6 | V
Résistance (Vfmax) | R | 38 | ohms | Utilisé | 39 | ohms

Sheet: DEL incertitude
Continuous forward current per segment | If | 0.03 | A
Forward voltage per segment (typ) | Vf | 1.9 | V
Forward voltage per segment (max) | Vf | 2.4 | V
Résistance | R | 36.66666667 | ohms | Utilisé | 33 | ohms

Sheet: Protection
Type | Utilisation | Protection
Short-circuit | x | Fuse
Overvoltage |  | Batterie atteigne environ 3,4 V max. Le circuit contrôle jusqu'à 3,3 V. Pas vraiment de différence. Les composants peuvent suporter cette tension.
Inversion de polarité |  | Batterie au lithium. Batterie à l'envers = aucune alimentation.
Overvoltage
Display | 0.200 | A |  | Zener voltage | 3.3 | R | 0.4074295986 | ohms
DEL | 0.030 | A |  | Power | 0.8099558824
Button | 0.003 | A
Zener | 0.01 | A
Atmega | 0.0025 | A
TOTAL | 0.245 | A
https://www.digikey.ca/en/products/detail/nexperia-usa-inc/1N4728A-113/1229016
https://www.digikey.ca/en/products/detail/nexperia-usa-inc/BZT52-B3V3X/8276684
Short circuit |  |  | https://youtu.be/yEAMr5TX3cU?si=WomWyZYUTAXtDybQ
Use a fuse
Fuse current | 0.368 | A

Sheet: Tests
 | Functions | Prog | Prog + hardware | Test effectué |  | Commentaires | Changements apportés
 | buttonSelected | TRUE | TRUE | TRUE | TRUE | Lorsque buttonValue et VCC sont forcés, ça fonctionne bien. Note : Les ranges ne changent pas selon VCC comme je pensais donc si ça ne fonctionne pas on peut retourner au code original (soit les ranges forcés avec 3V) | Doit changer la référence AREF afin de analogRead() soit sur 3V plutôt que 5V.
 | addNumber | FALSE | TRUE | TRUE |  |  | Doit ajouter un if pour l'ajout du point. Sinon, insère 46 et non '46'. Aussi, dans number += buttonS, on veut mettre String(buttonS) pour convertir le type.
 | inch2cent | TRUE | FALSE | TRUE |  | pour un résultat sous 100 cm, l'arrondissement ne s'effectue pas dans inch2cent (dans roundNumber c'est good) à voir si ça engendre des problème dans le display
effectuer ensemble | setNumber | FALSE | TRUE | TRUE
 | setDigit | FALSE | TRUE | TRUE
 | setDisplay | FALSE | TRUE | TRUE |  | Il y a un peu de ghosting (on voit une faible lumière sur les segments allumés pour le digit précedent)
 | roundNumber | TRUE | FALSE | TRUE |  | pow est un fct de Arduino, donc à retester (sinon ça fonctionne) | Doit ajouter 0.5 avant de le remettre en int afin d'arrondir par en haut
NON UTILISÉ | measureVcc | FALSE | TRUE | FALSE
NON UTILISÉ | voltageDivider | TRUE | FALSE | TRUE
NON UTILISÉ | adc_calculator | TRUE | FALSE | TRUE
 | L'ensemble du code ensemble |  |  | TRUE |  | Tester sur breadboard seulement. | Pour vider number, il faut utiliser number.remove(0). Aussi, il faut réinitialiser numberLength pour éviter des erreurs. Utiliser clearDigits() avant de reset array pour éteindre le display.
