elo3451/A24_ruler/Remise finale/Schema_electrique_5.pdf

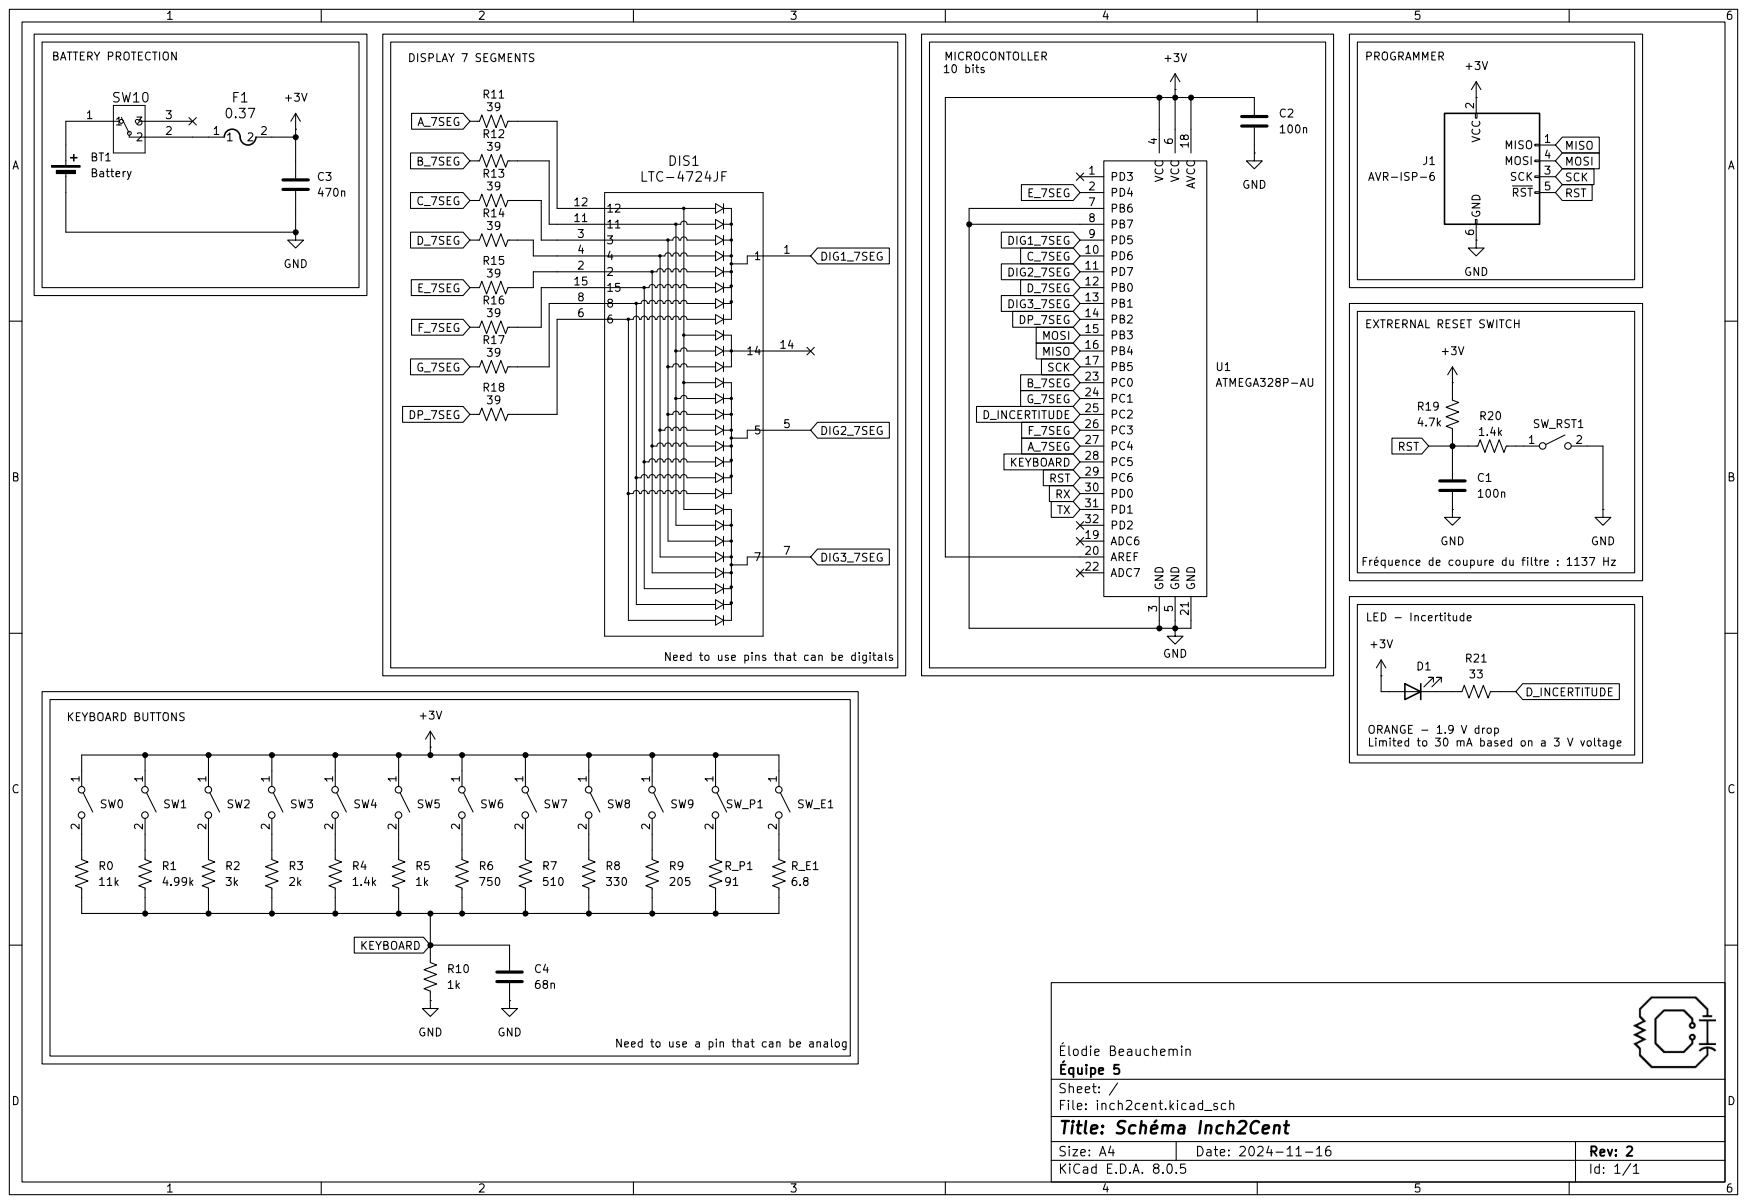
[picture p28: page 1]
