elo3451/A24_ruler/(commit log)

2024-10-14 push assemblage
2024-10-15 FRee samples list
2024-12-21 Add schéma électrique / PCB
2024-12-28 Remise finale
    [Conception.xlsx]
